zincVTD/TPMS/Hardware/TPMS/TPMS.kicad_pcb

## KiCad design Hardware/TPMS/TPMS.kicad_pcb (2025-06-04)

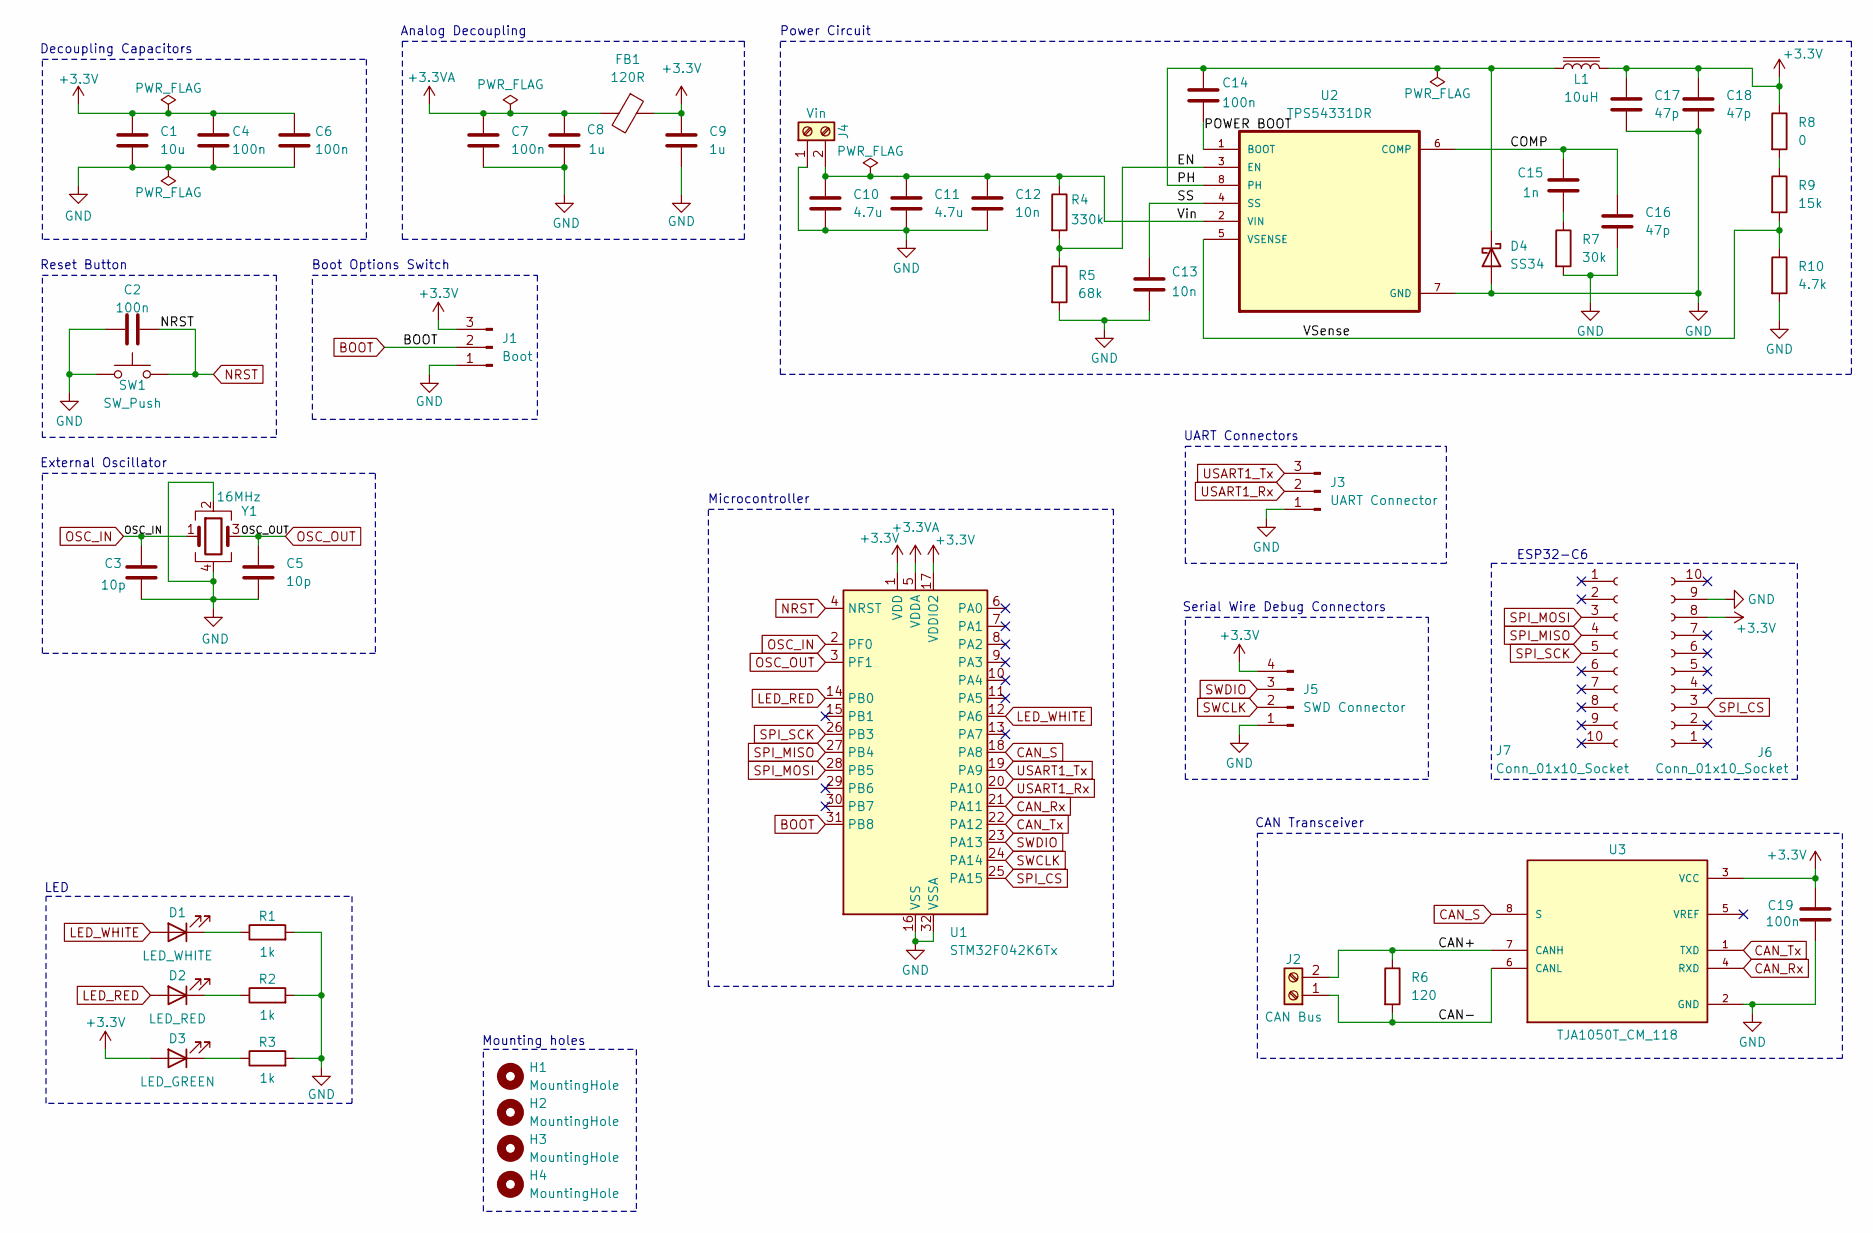
[picture p48: schematic TPMS.kicad_sch, STM32F0 TPMS ECU Development Board]

Parts:
C1: 10u; C_0603_1608Metric
C2, C4, C6, C7, C14, C19: 100n; C_0402_1005Metric
C3, C5: 10p; C_0402_1005Metric
C8, C9: 1u; C_0402_1005Metric
C10, C11: 4.7u; C_0603_1608Metric
C12, C13: 10n; C_0402_1005Metric
C15: 1n; C_0402_1005Metric
C16, C17, C18: 47p; C_0402_1005Metric
D1: LED_WHITE; LED_0603_1608Metric
D2: LED_RED; LED_0603_1608Metric
D3: LED_GREEN; LED_0805_2012Metric
D4: SS34; D_SMA
FB1: 120R; L_0805_2012Metric
H1, H2, H3, H4: MountingHole; MountingHole_2.5mm
J1: Boot; PinHeader_1x03_P2.54mm_Vertical
J2: CAN Bus; TerminalBlock_Phoenix_MKDS-1,5-2-5.08_1x02_P5.08mm_Horizont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
J3: UART Connector; PinHeader_1x03_P2.54mm_Vertical
J4: Vin; TerminalBlock_Phoenix_MKDS-1,5-2-5.08_1x02_P5.08mm_Horizont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
J5: SWD Connector; PinHeader_1x04_P2.54mm_Vertical
J6, J7: Conn_01x10_Socket; PinSocket_1x10_P2.54mm_Vertical
L1: 10uH; L_Sunlord_SWPA8040S
R1, R2, R3: 1k; R_0402_1005Metric
R4: 330k; R_0603_1608Metric
R5: 68k; R_0603_1608Metric
R6: 120; R_0402_1005Metric
R7: 30k; R_0603_1608Metric
R8: 0; R_0402_1005Metric
R9: 15k; R_0402_1005Metric
R10: 4.7k; R_0402_1005Metric
SW1: SW_Push; SW_SPST_TL3342
U1: STM32F042K6Tx; LQFP-32_7x7mm_P0.8mm
U2: TPS54331DR; SOIC127P599X175-8N
U3: TJA1050T_CM_118; SOIC127P600X175-8N; PARTREV 4
Y1: 16MHz; Crystal_SMD_3225-4Pin_3.2x2.5mm

Connections:
+3.3V: C1.1, C4.1, C6.1, C9.1, C17.1, C18.1, C19.1, D3.2 (A), FB1.1, J1.3, J5.4, J6.8, L1.2, R8.1, U1.1 (VDD), U1.17 (VDDIO2), U3.3 (VCC)
+3.3VA: C7.1, C8.1, FB1.2, U1.5 (VDDA)
/CAN+: J2.2, R6.1, U3.7 (CANH)
/CAN-: J2.1, R6.2, U3.6 (CANL)
/COMP: C15.1, C16.1, U2.6 (COMP)
/EN: R4.2, R5.1, U2.3 (EN)
/PH: C14.2, D4.1 (K), L1.1, U2.8 (PH)
/POWER BOOT: C14.1, U2.1 (BOOT)
/SS: C13.1, U2.4 (SS)
/VSense: R9.2, R10.1, U2.5 (VSENSE)
/Vin: C10.1, C11.1, C12.1, J4.2, R4.1, U2.2 (VIN)
BOOT: J1.2, U1.31 (PB8)
CAN_Rx: U1.21 (PA11), U3.4 (RXD)
CAN_S: U1.18 (PA8), U3.8 (S)
CAN_Tx: U1.22 (PA12), U3.1 (TXD)
GND: C1.2, C2.1, C3.2, C4.2, C5.2, C6.2, C7.2, C8.2, C9.2, C10.2, C11.2, C12.2, C13.2, C16.2, C17.2, C18.2, C19.2, D4.2 (A), J1.1, J3.1, J4.1, J5.1, J6.9, R1.2, R2.2, R3.2, R5.2, R7.2, R10.2, SW1.1, U1.16 (VSS), U1.32 (VSSA), U2.7 (GND), U3.2 (GND), Y1.2, Y1.4
LED_RED: D2.2 (A), U1.14 (PB0)
LED_WHITE: D1.2 (A), U1.12 (PA6)
NRST: C2.2, SW1.2, U1.4 (NRST)
unnamed: C15.2, R7.1
unnamed: D1.1 (K), R1.1
unnamed: D2.1 (K), R2.1
unnamed: D3.1 (K), R3.1
unnamed: R8.2, R9.1
OSC_IN: C3.1, U1.2 (PF0), Y1.1
OSC_OUT: C5.1, U1.3 (PF1), Y1.3
SPI_CS: J6.3, U1.25 (PA15)
SPI_MISO: J7.4, U1.27 (PB4)
SPI_MOSI: J7.3, U1.28 (PB5)
SPI_SCK: J7.5, U1.26 (PB3)
SWCLK: J5.2, U1.24 (PA14)
SWDIO: J5.3, U1.23 (PA13)
USART1_Rx: J3.2, U1.20 (PA10)
USART1_Tx: J3.3, U1.19 (PA9)

Notes on the sheet:
CAN Transceiver
LED
Boot Options Switch
External Oscillator
Serial Wire Debug Connectors
ESP32-C6
UART Connectors
Microcontroller
Analog Decoupling
Power Circuit
Decoupling Capacitors
Mounting holes
Reset Button

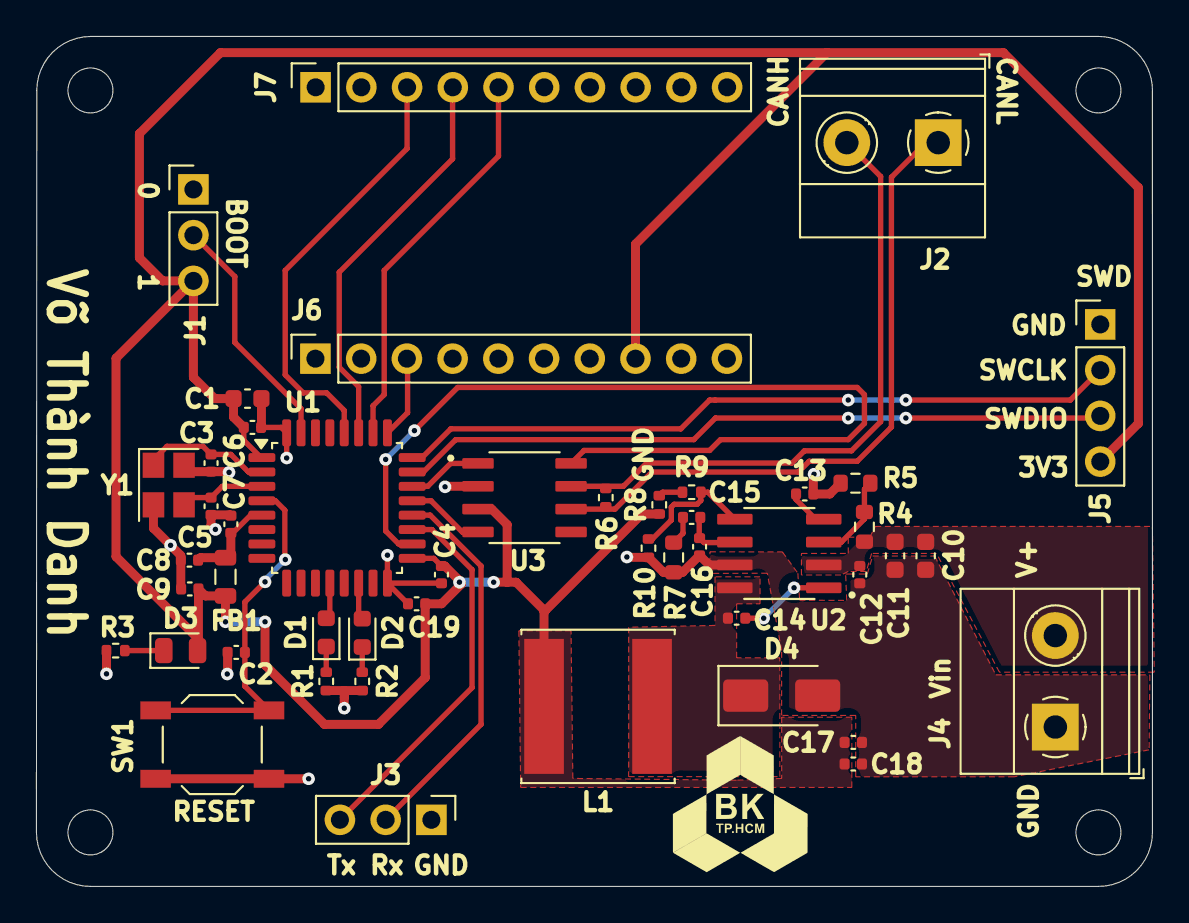
[picture p49: board TPMS.kicad_pcb from above]

Board: 2 copper layers, 62.0 x 47.2 mm, 51 parts (0 on the bottom side), 34 nets.
