zincVTD/TPMS/Monitor/OLED/OLED_LCD_SSD1306.h

/**
	Website: khuenguyencreator.com
	Ten Thu Vien: OLED_LCD_SSD1306
	Chuc Nang: Dieu khien man hinh SSD1306, SHT1103...
	Tac Gia: Khue Nguyen Creator
	Huong Dan Su dung: 
	- Khai báo I2C
	- Khai báo truoc main: SSD1306_Name SSD1306;
	- Khoi tao I2C cho LCD: SSD1306_Init(&SSD1306, &hi2c1);
	- Su dung cac ham phai truyen vào &SSD1306
			SSD1306_Clear(&SSD1306);
			SSD1306_GotoXY(&SSD1306, 1,1);
			SSD1306_Puts(&SSD1306, "KHUE NGUYEN", &Font_11x18, SSD1306_COLOR_WHITE);
   ----------------------------------------------------------------------
 */
#ifndef __OLED_LCD_SSD1306_H
#define __OLED_LCD_SSD1306_H 
#include "fonts.h"
#include "stdlib.h"
#include "string.h"
/* SSD1306 settings */
#define SSD1306_RIGHT_HORIZONTAL_SCROLL              0x26
#define SSD1306_LEFT_HORIZONTAL_SCROLL               0x27
#define SSD1306_VERTICAL_AND_RIGHT_HORIZONTAL_SCROLL 0x29
#define SSD1306_VERTICAL_AND_LEFT_HORIZONTAL_SCROLL  0x2A
#define SSD1306_DEACTIVATE_SCROLL                    0x2E // Stop scroll
#define SSD1306_ACTIVATE_SCROLL                      0x2F // Start scroll
#define SSD1306_SET_VERTICAL_SCROLL_AREA             0xA3 // Set scroll range

#define SSD1306_NORMALDISPLAY       0xA6
#define SSD1306_INVERTDISPLAY       0xA7
/* I2C address */
#ifndef SSD1306_I2C_ADDR
#define SSD1306_I2C_ADDR         0x78
//#define SSD1306_I2C_ADDR       0x7A
#endif


/* SSD1306 width in pixels */
#ifndef SSD1306_WIDTH
#define SSD1306_WIDTH            132
#endif
/* SSD1306 LCD height in pixels */
#ifndef SSD1306_HEIGHT
#define SSD1306_HEIGHT           64
#endif
#ifndef ssd1306_I2C_TIMEOUT
#define ssd1306_I2C_TIMEOUT					20000
#endif

/**
 * @brief  SSD1306 color enumeration
 */
typedef enum {
	SSD1306_COLOR_BLACK = 0x00, /*!< Black color, no pixel */
	SSD1306_COLOR_WHITE = 0x01  /*!< Pixel is set. Color depends on LCD */
} SSD1306_COLOR_t;


typedef struct {
	I2C_TypeDef* I2C;
	uint16_t CurrentX;
	uint16_t CurrentY;
	uint8_t Inverted;
	uint8_t Initialized;
	uint8_t SSD1306_Buffer[SSD1306_WIDTH * SSD1306_HEIGHT / 8];
} SSD1306_Name;

/**
 * @brief  Initializes SSD1306 LCD
 * @param  None
 * @retval Initialization status:
 *           - 0: LCD was not detected on I2C port
 *           - > 0: LCD initialized OK and ready to use
 */
uint8_t SSD1306_Init(SSD1306_Name* SSD1306, I2C_TypeDef* I2C);

/** 
 * @brief  Updates buffer from internal RAM to LCD
 * @note   This function must be called each time you do some changes to LCD, to update buffer from RAM to LCD
 * @param  None
 * @retval None
 */
void SSD1306_UpdateScreen(SSD1306_Name* SSD1306);

/**
 * @brief  Toggles pixels invertion inside internal RAM
 * @note   @ref SSD1306_UpdateScreen() must be called after that in order to see updated LCD screen
 * @param  None
 * @retval None
 */
void SSD1306_ToggleInvert(SSD1306_Name* SSD1306);

/** 
 * @brief  Fills entire LCD with desired color
 * @note   @ref SSD1306_UpdateScreen() must be called after that in order to see updated LCD screen
 * @param  Color: Color to be used for screen fill. This parameter can be a value of @ref SSD1306_COLOR_t enumeration
 * @retval None
 */
void SSD1306_Fill(SSD1306_Name* SSD1306, SSD1306_COLOR_t Color);

/**
 * @brief  Draws pixel at desired location
 * @note   @ref SSD1306_UpdateScreen() must called after that in order to see updated LCD screen
 * @param  x: X location. This parameter can be a value between 0 and SSD1306_WIDTH - 1
 * @param  y: Y location. This parameter can be a value between 0 and SSD1306_HEIGHT - 1
 * @param  color: Color to be used for screen fill. This parameter can be a value of @ref SSD1306_COLOR_t enumeration
 * @retval None
 */
void SSD1306_DrawPixel(SSD1306_Name* SSD1306, uint16_t x, uint16_t y, SSD1306_COLOR_t color);

/**
 * @brief  Sets cursor pointer to desired location for strings
 * @param  x: X location. This parameter can be a value between 0 and SSD1306_WIDTH - 1
 * @param  y: Y location. This parameter can be a value between 0 and SSD1306_HEIGHT - 1
 * @retval None
 */
void SSD1306_GotoXY(SSD1306_Name* SSD1306, uint16_t x, uint16_t y);

/**
 * @brief  Puts character to internal RAM
 * @note   @ref SSD1306_UpdateScreen() must be called after that in order to see updated LCD screen
 * @param  ch: Character to be written
 * @param  *Font: Pointer to @ref FontDef_t structure with used font
 * @param  color: Color used for drawing. This parameter can be a value of @ref SSD1306_COLOR_t enumeration
 * @retval Character written
 */
char SSD1306_Putc(SSD1306_Name* SSD1306, char ch, FontDef_t* Font, SSD1306_COLOR_t color);

/**
 * @brief  Puts string to internal RAM
 * @note   @ref SSD1306_UpdateScreen() must be called after that in order to see updated LCD screen
 * @param  *str: String to be written
 * @param  *Font: Pointer to @ref FontDef_t structure with used font
 * @param  color: Color used for drawing. This parameter can be a value of @ref SSD1306_COLOR_t enumeration
 * @retval Zero on success or character value when function failed
 */
char SSD1306_Puts(SSD1306_Name* SSD1306, char* str, FontDef_t* Font, SSD1306_COLOR_t color);

/**
 * @brief  Draws line on LCD
 * @note   @ref SSD1306_UpdateScreen() must be called after that in order to see updated LCD screen
 * @param  x0: Line X start point. Valid input is 0 to SSD1306_WIDTH - 1
 * @param  y0: Line Y start point. Valid input is 0 to SSD1306_HEIGHT - 1
 * @param  x1: Line X end point. Valid input is 0 to SSD1306_WIDTH - 1
 * @param  y1: Line Y end point. Valid input is 0 to SSD1306_HEIGHT - 1
 * @param  c: Color to be used. This parameter can be a value of @ref SSD1306_COLOR_t enumeration
 * @retval None
 */
void SSD1306_DrawLine(SSD1306_Name* SSD1306, uint16_t x0, uint16_t y0, uint16_t x1, uint16_t y1, SSD1306_COLOR_t c);

/**
 * @brief  Draws rectangle on LCD
 * @note   @ref SSD1306_UpdateScreen() must be called after that in order to see updated LCD screen
 * @param  x: Top left X start point. Valid input is 0 to SSD1306_WIDTH - 1
 * @param  y: Top left Y start point. Valid input is 0 to SSD1306_HEIGHT - 1
 * @param  w: Rectangle width in units of pixels
 * @param  h: Rectangle height in units of pixels
 * @param  c: Color to be used. This parameter can be a value of @ref SSD1306_COLOR_t enumeration
 * @retval None
 */
void SSD1306_DrawRectangle(SSD1306_Name* SSD1306, uint16_t x, uint16_t y, uint16_t w, uint16_t h, SSD1306_COLOR_t c);

/**
 * @brief  Draws filled rectangle on LCD
 * @note   @ref SSD1306_UpdateScreen() must be called after that in order to see updated LCD screen
 * @param  x: Top left X start point. Valid input is 0 to SSD1306_WIDTH - 1
 * @param  y: Top left Y start point. Valid input is 0 to SSD1306_HEIGHT - 1
 * @param  w: Rectangle width in units of pixels
 * @param  h: Rectangle height in units of pixels
 * @param  c: Color to be used. This parameter can be a value of @ref SSD1306_COLOR_t enumeration
 * @retval None
 */
void SSD1306_DrawFilledRectangle(SSD1306_Name* SSD1306, uint16_t x, uint16_t y, uint16_t w, uint16_t h, SSD1306_COLOR_t c);

/**
 * @brief  Draws triangle on LCD
 * @note   @ref SSD1306_UpdateScreen() must be called after that in order to see updated LCD screen
 * @param  x1: First coordinate X location. Valid input is 0 to SSD1306_WIDTH - 1
 * @param  y1: First coordinate Y location. Valid input is 0 to SSD1306_HEIGHT - 1
 * @param  x2: Second coordinate X location. Valid input is 0 to SSD1306_WIDTH - 1
 * @param  y2: Second coordinate Y location. Valid input is 0 to SSD1306_HEIGHT - 1
 * @param  x3: Third coordinate X location. Valid input is 0 to SSD1306_WIDTH - 1
 * @param  y3: Third coordinate Y location. Valid input is 0 to SSD1306_HEIGHT - 1
 * @param  c: Color to be used. This parameter can be a value of @ref SSD1306_COLOR_t enumeration
 * @retval None
 */
void SSD1306_DrawTriangle(SSD1306_Name* SSD1306, uint16_t x1, uint16_t y1, uint16_t x2, uint16_t y2, uint16_t x3, uint16_t y3, SSD1306_COLOR_t color);

/**
 * @brief  Draws circle to STM buffer
 * @note   @ref SSD1306_UpdateScreen() must be called after that in order to see updated LCD screen
 * @param  x: X location for center of circle. Valid input is 0 to SSD1306_WIDTH - 1
 * @param  y: Y location for center of circle. Valid input is 0 to SSD1306_HEIGHT - 1
 * @param  r: Circle radius in units of pixels
 * @param  c: Color to be used. This parameter can be a value of @ref SSD1306_COLOR_t enumeration
 * @retval None
 */
void SSD1306_DrawCircle(SSD1306_Name* SSD1306, int16_t x0, int16_t y0, int16_t r, SSD1306_COLOR_t c);

/**
 * @brief  Draws filled circle to STM buffer
 * @note   @ref SSD1306_UpdateScreen() must be called after that in order to see updated LCD screen
 * @param  x: X location for center of circle. Valid input is 0 to SSD1306_WIDTH - 1
 * @param  y: Y location for center of circle. Valid input is 0 to SSD1306_HEIGHT - 1
 * @param  r: Circle radius in units of pixels
 * @param  c: Color to be used. This parameter can be a value of @ref SSD1306_COLOR_t enumeration
 * @retval None
 */
void SSD1306_DrawFilledCircle(SSD1306_Name* SSD1306, int16_t x0, int16_t y0, int16_t r, SSD1306_COLOR_t c);

/**
 * @brief  Draws bitmap pickture
 * @note   @ref SSD1306_UpdateScreen() must be called after that in order to see updated LCD screen
 * @param  x: X location for start. Valid input is 0 to SSD1306_WIDTH - 1
 * @param  y: Y location for start of circle. Valid input is 0 to SSD1306_HEIGHT - 1
 * @param  w: weight of bitmap
 * @param  h: hight of bitmap
 * @param  color: Color to be used. This parameter can be a value of @ref SSD1306_COLOR_t enumeration
 * @retval None
 */
void SSD1306_DrawBitmap(SSD1306_Name* SSD1306,int16_t x, int16_t y, const unsigned char* bitmap, int16_t w, int16_t h, SSD1306_COLOR_t color);

//SSD1306 Command
void SSD1306_ScrollRight(SSD1306_Name* SSD1306,uint8_t start_row, uint8_t end_row);
void SSD1306_ScrollLeft(SSD1306_Name* SSD1306,uint8_t start_row, uint8_t end_row);
void SSD1306_Scrolldiagright(SSD1306_Name* SSD1306,uint8_t start_row, uint8_t end_row);
void SSD1306_Scrolldiagleft(SSD1306_Name* SSD1306,uint8_t start_row, uint8_t end_row);
void SSD1306_Stopscroll(SSD1306_Name* SSD1306);
void SSD1306_InvertDisplay(SSD1306_Name* SSD1306,int i);
void SSD1306_Clear(SSD1306_Name* SSD1306);
void SSD1306_ON(SSD1306_Name* SSD1306);
void SSD1306_OFF(SSD1306_Name* SSD1306);
/* C++ detection */
#ifdef __cplusplus
}
#endif

#endif
