zincVTD/TPMS/Monitor/OLED/timer.c

#include "stm32f10x.h"                  // Device header
#include "stm32f10x_rcc.h"              // Keil::Device:StdPeriph Drivers:RCC
#include "stm32f10x_tim.h"              // Keil::Device:StdPeriph Drivers:TIM
#include "timer.h"


void TIM2_Config(void){
	
	RCC_APB1PeriphClockCmd(RCC_APB1Periph_TIM2, ENABLE);
	TIM_TimeBaseInitTypeDef TIM_InitStruct;
	
	TIM_InitStruct.TIM_ClockDivision = TIM_CKD_DIV1;
	TIM_InitStruct.TIM_Prescaler = 7200 - 1;
	TIM_InitStruct.TIM_Period = 0xFFFF;
	TIM_InitStruct.TIM_CounterMode = TIM_CounterMode_Up;
	
	TIM_TimeBaseInit(TIM2, &TIM_InitStruct);
	TIM_Cmd(TIM2, ENABLE);
}

void delay(uint32_t time){
	TIM_SetCounter(TIM2, 0);
	while(TIM_GetCounter(TIM2) < time);
}
